twhunq/Fall-Detect/docs/reports/Slide_Thuyet_Trinh_Nhom_1.html

Tổng quan: nhấp vào slide để mở, phím O hoặc Esc để đóng

Logo ICTU

Trường Đại học Công nghệ Thông tin và Truyền thông, Đại học Thái NguyênKhoa Kỹ thuật và Công nghệ

Tiểu luận học phần Internet Vạn Vật

# Hệ thống IoT phát hiện và cảnh báo té ngã

Vòng đeo TinyML trên ESP32-S3 kết hợp camera AI CanMV K230

Nhóm thực hiệnNhóm 1, lớp VMBD K23A

Giảng viên hướng dẫnTS. Vũ Chiến Thắng

Thời gianTháng 10/2026

Chào thầy và các bạn. Nhóm 1 trình bày hệ thống IoT phát hiện và cảnh báo té ngã, gồm hai thiết bị: vòng đeo TinyML trên ESP32-S3 và camera AI CanMV K230, cùng ứng dụng di động «Báo Ngã IoT».

Đường vẽ dưới tiêu đề là độ lớn gia tốc |a| của một cú ngã: đi lại bình thường, rơi tự do (|a| tụt xuống), va đập (vọt lên), rồi nằm yên. Đây cũng là chuỗi mà thuật toán của nhóm theo dõi. Thời lượng khoảng 15 phút, sau đó demo.

Phím: → / Space bước tiếp; N ghi chú; Shift+N cửa sổ ghi chú có đồng hồ; M bật/tắt hoạt cảnh (mặc định bật); mở với ?static để hiện ngay trạng thái cuối.

## Nguy hiểm nhất là nằm bất động sau ngã mà không ai biết

30–60phút

Nằm chờ lâu hơn mức này: hạ thân nhiệt, tiêu cơ vân, suy thận cấp, tỷ lệ tử vong tăng gấp đôi.

Mục tiêu: báo ngay khi xác nhận ngã

Vùng nguy hiểm

Ngã

30 phút

60 phút

#### Báo tại chỗ, không cần mạng

Còi và LED bật ngay; một chạm để tắt nếu báo nhầm.

#### Hai nguồn độc lập

Vòng đeo trên người và camera trong phòng.

#### Nhiều kênh cùng chạy

Kênh tới trước báo trước, các kênh sau làm dự phòng.

Theo WHO, té ngã là nguyên nhân tử vong do chấn thương không chủ ý đứng thứ hai toàn cầu.

Theo WHO, té ngã là nguyên nhân tử vong do chấn thương không chủ ý đứng thứ hai toàn cầu. Điều quyết định hậu quả không chỉ là cú va đập mà là thời gian nằm bất động (long-lie): chậm phát hiện quá 30–60 phút có thể dẫn đến hạ thân nhiệt, mất nước, tiêu cơ vân, suy thận cấp và làm tăng gấp đôi tỷ lệ tử vong (mục 1.1 báo cáo).

Giải pháp đơn lẻ còn hở: chỉ ngưỡng gia tốc thì báo giả khi ngồi phịch xuống ghế; chỉ camera thì có điểm mù và vấn đề riêng tư; chỉ xử lý trên cloud thì mất Internet là mất bảo vệ.

Bấm → hiện ba mục tiêu thiết kế.

## Hai thiết bị tự phát hiện tại chỗ, nhiều đường cùng chạy tới điện thoại

Mỗi thiết bị tự chạy AI tại biên, không cần máy chủ để quyết định ngãLớp tại chỗ: còi và LED bật ngay, không phụ thuộc mạngTrong nhà: gói UDP 4210 và Web Portal đi thẳng qua Wi-Fi, không cần TLSCầu nối camera phát BLE NOTIFY thẳng tới điện thoại ở gầnQua Internet: Firebase đẩy SSE tới app, Telegram và Gmail tới người thân

Bấm → bốn lần, mỗi lần bật một nhóm đường truyền.
(1) Tại chỗ: còi + LED trên vòng đeo, chạy độc lập mạng.
(2) Mạng nhà: vòng đeo và cầu nối camera phát gói UDP cổng 4210; ứng dụng hỏi Web Portal /api/status mỗi 2 s.
(3) Camera K230 gửi sự kiện qua UART 921600 sang cầu nối ESP32-S3; cầu nối phát BLE NOTIFY cho điện thoại ở gần.
(4) Qua Internet: Firebase Realtime Database đẩy SSE tới ứng dụng; Telegram và Gmail tới người thân; ảnh bằng chứng lên Cloud Relay.

Từ slide sau, sơ đồ này thu nhỏ ở góc phải để đánh dấu phần đang trình bày.

## Toàn bộ vòng đeo nằm trên một PCB 2 lớp 60 × 50 mm

Mô hình 3D mạch in vòng đeo (KiCad 10)

±4 g ±500 °/s

MPU6050 lấy mẫu 50 Hz qua I2C

0 lỗi DRC/ERC

Thiết kế trên KiCad 10

~14–18 giờ

Giám sát liên tục, pin 1000 mAh (ước tính)

~0,42 mA

Ngủ sâu toàn mạch, hơn 60 ngày chờ

Ảnh: mô hình 3D mạch in từ KiCad 10 (Hình 2.3–2.4). Bấm → hiện chú thích linh kiện, bấm tiếp → số liệu điện năng (Bảng 2.3, ước tính).

GPIO đã đối chiếu PCB: SDA 8, SCL 9, MPU INT 7, TTP223 OUT 4 (HIGH khi chạm), còi chủ động 5 qua Q1 S8050, LED đỏ 6, ADC pin 1 (cầu 100k/100k, đo tại VSW trước diode 1N5817), GPIO48 là LED RGB trạng thái mạng.
TTP223: chạm 1 lần tắt còi; chạm 3 lần hiệu chuẩn; giữ 3 s ngủ sâu.
Điện năng: giám sát liên tục ~52–65 mA (~14–18 giờ với pin 1000 mAh); báo động ~95–130 mA trong 15–30 s; ngủ sâu ~0,42 mA toàn mạch (ESP32-S3 ~8 µA).
Câu hỏi hay gặp: vì sao đo pin trước diode (tránh sai số sụt áp, không rò dòng khi tắt công tắc).

## Ngã = va đập + bằng chứng + nằm yên ở tư thế mới

Mỗi 20 ms: đọc cảm biến, lọc, rồi chờ một cú va đập |a| ≥ 2,0 gVa đập: sự kiện nghi ngã (fall candidate), thiết lập kết nối trước (connection pre-warming)Tại t₀ + 3 s phải đủ cả hai điều kiện mới báo ngã, thiếu một là loại bỏ (rejected)Song song, MLP xét cửa sổ 1 s và góp một phiếu bằng chứngCa ngã thật: rơi tự do, va đập, nằm yên ở tư thế mới, báo độngVấp rồi tự đứng dậy: có bằng chứng nhưng không nằm yên, loại bỏ

Lưu đồ đúng theo mã nguồn: fall_detection_esp32.ino (updateSensor), fall_detector.h, detection_config.h, board_config.h.
Bấm → lần lượt: (1) nhánh chờ, (2) pha xác minh sự kiện nghi ngã (fall candidate), (3) hai quyết định, (4) nhánh MLP, (5) token chạy ca ngã thật, (6) ca bị loại.

• Đọc MPU6050 ±4 g, ±500 °/s; lọc nhiễu, trừ bias gyro (cập nhật chậm khi đứng yên), xoay về hệ trục chuẩn đã hiệu chỉnh khi đứng.
• CHỜ: tư thế tham chiếu là trung bình chậm của vector trọng lực khi ít chuyển động; ghi rơi tự do nếu |a| < 0,6 g.
• |a| ≥ 2,0 g → phát hiện nghi ngã tại t₀, bắt đầu pha xác minh: lưu tư thế trước, có rơi tự do trong 1 s trước va đập không, đỉnh tốc độ quay. Ngay lúc đó thiết lập kết nối trước (connection pre-warming): tắt Modem Sleep 10 s, CloudSync dựng sẵn phiên TLS (keep-alive).
• 0–1 s: pha ổn định (settling, bỏ qua nảy), vẫn cập nhật đỉnh |a|, đỉnh quay (đến 1,5 s) và phiếu ML.
• 1–3 s: pha xác minh tư thế, đếm tỉ lệ mẫu yên (| |a| − 1 | < 0,2 g và |ω| < 30 °/s), cộng dồn hướng trọng lực sau ngã.
• Tại 3 s: Bằng chứng = rơi tự do HOẶC phiếu ML HOẶC đỉnh quay ≥ 120 °/s; Nằm xuống = tỉ lệ yên ≥ 80 % VÀ góc lệch so với trước va đập ≥ 45°. Đủ cả hai → NGÃ; ngược lại loại bỏ (rejected): log «[FALL?] … -> bo qua» và về CHỜ. Không có nhánh «đứng dậy → hủy» riêng: đứng dậy làm tỉ lệ yên hoặc góc không đạt.
• NGÃ → AlertController.trigger (bị chặn 10 s sau lần chạm xác nhận trước; không kích hoạt chồng khi đang báo) → còi + LED, UDP ×3 (0/20/40 ms), đánh thức CloudSync (Fast-Flush Firebase) rồi Notifier (Telegram → Gmail). Chạm TTP223 tắt báo động tại chỗ.
• Song song: InactivityMonitor đếm thời gian bất động (mặc định 60 phút, chỉnh 1–1440) → cảnh báo vàng, tự báo «đã cử động trở lại».
Kết quả T02: còi bật sau 3,02 s (1 s ổn định + 2 s xác minh tư thế).

## Trên tín hiệu |a|, cú ngã hiện rõ ba mốc của lưu đồ

Đi lại bình thường: |a| dao động quanh 1 gRơi tự do: |a| tụt dưới 0,6 g, được ghi lại làm bằng chứngVa đập |a| ≥ 2,0 g tại t₀: phát hiện nghi ngã, thiết lập kết nối trướcPha ổn định 1 s; MLP xét cửa sổ quanh va đập và góp phiếu ngãPha xác minh tư thế 2 s: nằm yên, lệch tư thế đủ lớn, xác nhận ngã tại t₀ + 3 s

#### MLP 30 → 16 → 8 → 5 chạy ngay trên ESP32-S3

30 đặc trưng mỗi 200 ms: trung bình, độ lệch, max, min, RMS của 6 kênh.

677 tham số; kết quả C++ khớp NumPy, sai lệch < 0,0001.

Đường |a| là minh họa dựng theo mô tả Hình 3.6 của báo cáo, không phải bản ghi thô. Bấm → lần lượt từng mốc, khớp với lưu đồ slide trước.

MLP: cửa sổ 50 mẫu × 6 kênh (1 s), trượt 10 mẫu (200 ms); 30 đặc trưng = μ, σ, max, min, RMS × 6 kênh, chuẩn hóa Z-score; mạng 30 → 16 (ReLU) → 8 (ReLU) → 5 (Softmax), 677 tham số float32 (W1 480, b1 16, W2 128, b2 8, W3 40, b3 5) lưu trong Flash, không cấp phát động. 5 lớp: bình thường, ngã, ngồi, nằm, chạy.
Phiếu ML chỉ tính khi lớp «ngã» có độ tin cậy ≥ 0,70 và trong 1,5 s sau va đập.
So khớp C++17 với NumPy: sai lệch tuyệt đối lớn nhất < 0,0001 trên 602 cửa sổ. Train/Test 100 % trên tập dữ liệu chuẩn hóa quy mô vừa của nhóm (nói trung thực: cần tinh chỉnh trên SisFall). T02: lớp «ngã» đạt 94–99 %.

## Camera chỉ báo khi 6/10 khung đồng ý, giữ đủ 1,5 s

Mỗi khung: YOLOv5n tìm người, tracker giữ đúng danh tính qua các khungMột phiếu ngã chỉ khi người đang nằm và có thêm dấu hiệu ngãBỏ phiếu 6 trong 10 khung gần nhất để lọc nhiễu từng khungMáy trạng thái 3 trạng thái cho mỗi người: NORMAL, SUSPECT, ALARMCa ngã: đủ 6/10 phiếu, giữ 1,5 s, vào ALARM và gửi sự kiệnCúi nhặt đồ: phiếu tụt xuống trước 1,5 s, quay về NORMAL

Đúng theo falldown_detect.py (tham số lớp CFG; Track.update và Track._step_state).
• Ảnh 640 × 360, đưa vào YOLOv5n 640 × 640 (lớp Fall/NoFall), ngưỡng tin cậy 0,30, NMS 0,45. Ghép track khi IoU ≥ 0,30; mất dấu quá 2 s thì xóa track. (Giá trị theo mã nguồn hiện tại.)
• Tín hiệu mỗi khung: nằm = tỉ lệ w/h > 0,95; tụt nhanh = tâm khung tụt > 18 % chiều cao ảnh trong 8 khung. Phiếu = 1 khi NẰM và (model báo Fall HOẶC tụt nhanh); model báo Fall nhưng vẫn đứng → phiếu 0.
• «Đã ngã» khi ≥ 6 phiếu trong 10 khung gần nhất.
• NORMAL → SUSPECT khi đã ngã. SUSPECT → NORMAL nếu hết «đã ngã» (cúi, ngồi). Giữ SUSPECT ≥ 1,5 s → ALARM nếu đã qua 15 s từ lần báo trước, ngược lại về NORMAL. ALARM → NORMAL khi hết «đã ngã» liên tục ≥ 3 s (đứng dậy).
• Vào ALARM: gửi FALL qua UART 921600 sang cầu nối ESP32-S3 (BLE NOTIFY ngay, UDP, Relay/Telegram) và lưu ảnh bằng chứng. Tốc độ thực đo ~26 FPS (T11), bản tin UART < 5 ms.
Hoạt cảnh là minh họa chiếu chậm.

## Chỉ một phiên TLS mỗi lúc, cảnh báo khẩn được đi trước

### Mở chồng phiên TLSvấn đề

RAM trong (SRAM) còn trống

Firebase

Telegram

Gmail

Mỗi phiên cần ~40–46 KB: mở cùng lúc là cạn RAM, thiết bị khởi động lại.

### TlsGategiải pháp

1 phiên tại mọi thời điểm

Các tác vụ xếp hàng qua cổng.

Đệm TLS nằm ở PSRAM

SRAM còn dư cho Wi-Fi và Web Portal.

Firebase, Telegram và Gmail đều là TLS. Mỗi phiên cần khoảng 40–46 KB heap; mở chồng nhiều phiên là cạn SRAM và thiết bị khởi động lại.
Giải pháp: (1) cấp phát đệm mbedTLS sang PSRAM 2 MB (tlsCalloc), SRAM trống tăng thêm > 60 KB (số đo phiên bản trước); (2) khóa TlsGate tuần tự hóa: tối đa 1 phiên TLS tại mọi thời điểm.
Bấm → TlsGate; bấm tiếp → thứ tự khi có ngã: CloudSync đang giữ phiên TLS dựng sẵn làm Fast-Flush PUT trạng thái báo động lên Firebase, nhả cổng, rồi Notifier gửi Telegram, sau đó Gmail.
Các kênh khác: Web Portal baonga.local (cập nhật 1 s, SoftAP BaoNga-Setup khi chưa có Wi-Fi), Firebase RTDB + Hosting với quy tắc 3 vai trò device/owner/viewer. T08: Telegram=OK, Gmail=OK, heap trống > 120 KB.

## Năm lớp tăng tốc: kênh nào tới trước thì báo trước

1

#### UDP trong mạng nhàvòng đeo, cầu nối camera

3 gói cùng seq, cổng 4210, không TLS

< 15 mstrong mạng nội bộ

2

#### BLE không chặncầu nối camera

NOTIFY ngay khi nhận sự kiện ngã

~0 mslần gửi đầu tiên

3

#### Thiết lập kết nối trướcvòng đeo

Tắt Modem Sleep, dựng sẵn phiên TLS từ lúc va đập

0 lần bắt taykhi cần gửi

4

#### Fast-Flush Firebasevòng đeo

PUT báo động trên phiên TLS dựng sẵn (keep-alive)

~150 msgiới hạn chờ 1,5 s

5

#### Đua đa kênhứng dụng Báo Ngã IoT

Nghe mọi kênh, khử trùng lặp

kênh nhanh nhấtbật báo động

Cột phải là giá trị thiết kế (Bảng 3.15).

Trước đây mọi cảnh báo từ xa đi qua HTTPS/SMTPS, phải chờ bắt tay TLS, thường mất vài giây. Nay các đường chạy song song và độc lập về giao thức; đường chậm hơn là dự phòng khi đường nhanh đứt.
(1) UDP: 3 gói cùng seq cách 20 ms, broadcast + unicast tới tối đa 4 điện thoại vừa hỏi /api/status, cổng 4210, định dạng BAONGA|1|seq|device|FALL|metric|ip.
(2) BLE: NOTIFY đầu tại ~0 ms, các lần lặp do BleAlert::loop() đảm nhận; đường mạng phía sau bắt đầu sớm hơn 800 ms.
(3) Thiết lập kết nối trước: từ lúc va đập, tắt Modem Sleep 10 s, CloudSync dựng sẵn phiên TLS Firebase.
(4) Zero-Wait + Fast-Flush: đánh thức tác vụ bằng task notification, PUT trạng thái alarm ~150 ms (timeout 1,5 s) rồi nhường TlsGate.
(5) Ứng dụng nghe mọi kênh; kênh tới đầu tiên bật báo động, bản tin sau được khử trùng lặp.
Nhấn mạnh: các số ở cột phải là giá trị thiết kế (Bảng 3.15); độ trễ thật của từng sự cố xem ở mục «Thông tin kỹ thuật» trong chi tiết sự cố (tab Lịch sử) của ứng dụng.

## Mô phỏng: một cú ngã, sáu đường cùng chạy tới điện thoại

Vị trí về đích theo giá trị thiết kế, trục thời gian logaritCùng Wi-Fi nhà: UDP tới trước và bật báo động, các kênh sau chỉ ghi thêmNgười thân ở ngoài: chỉ còn đường Internet, Firebase tới trước

t = 0 msđồng hồ mô phỏng

Cùng Wi-Fi nhàỞ ngoài (4G)Phát lại

Mô phỏng theo giá trị thiết kế (Bảng 3.15), không phải số đo: UDP < 15 ms; BLE gửi tại ~0 ms (vị trí về đích minh họa); Firebase PUT ~150 ms rồi SSE; Portal hỏi mỗi 2 s; Telegram và Gmail vài giây (Gmail sau Telegram).
Bấm → kịch bản điện thoại cùng Wi-Fi: UDP tới trước, bật báo động; các kênh sau chỉ ghi thêm thời điểm tới, không đổ chuông lần hai. Bấm tiếp → người thân ở ngoài: UDP, BLE, Portal không khả dụng; Firebase SSE tới trước. Có thể bấm các nút trên khung để chạy lại.

## Tận dụng 3 giây xác minh để thiết lập kết nối trước, rồi đẩy Firebase đầu tiên

Vòng đeo, từ lúc va đập tới khi tin nhắn đi (giá trị thiết kế)t₀ va đập: thiết lập kết nối trước, tắt Modem Sleep 10 s, dựng sẵn phiên TLSt₀ + 3 s xác nhận: còi, LED và 3 gói UDP đi ngay, tác vụ mạng được đánh thứcFast-Flush trên phiên TLS dựng sẵn, nhả cổng, rồi Telegram và Gmail

Bấm → từng bước (Bảng 3.7, 3.8; giá trị thiết kế).
(1) Va đập ≥ 2 g, thiết lập kết nối trước: notifier.boost(10000) tắt Modem Sleep 10 s, cloud.prewarm() dựng sẵn phiên TLS Firebase.
(2) 3 s xác minh (1 s ổn định + 2 s xác minh tư thế): nếu sự kiện nghi ngã bị loại bỏ thì không phát gì, chi phí chỉ là Wi-Fi tốn điện thêm ≤ 10 s.
(3) Xác nhận: còi/LED; gói UDP 0/20/40 ms; đánh thức CloudSync và Notifier bằng task notification thay vì chờ chu kỳ.
(4) Fast-Flush: PUT alarm trên phiên TLS dựng sẵn (~150 ms, timeout 1,5 s), releaseTls(), Notifier gửi Telegram rồi Gmail. Luôn tối đa 1 phiên TLS.
Thêm (không có trên slide): cầu nối camera trước đây NOTIFY ×3 xen delay(400) chặn 800 ms rồi mới gọi HTTPS. Nay: NOTIFY và UDP tại 0 ms, HTTPS ngay sau; các lần lặp xử lý trong loop(). «Sớm hơn 800 ms» là hệ quả trực tiếp của việc bỏ 2 lần delay(400), không phải số đo. Hạn chế còn lại: lần lặp có thể bị hoãn khi loop() chờ HTTPS; hướng phát triển là đưa HTTPS sang task FreeRTOS riêng.

## Nhiều kênh, một sự cố: chỉ hú còi một lần, không bỏ sót cú ngã thứ hai

#### Tín hiệu tới ứng dụng (kịch bản minh họa)

#### Sự cố trên ứng dụng

AlertFusionEngine.ingest() (mobile/lib/core/fusion/alert_fusion_engine.dart). Nguồn: UDP 4210, BLE ALERT, Firebase SSE, Web Portal /api/status (2 s); trên app hiện là UDP, BLE, Cloud, LAN.
Quy tắc: (a) bản sao cùng nguồn, cùng loại trong 60 s bị khử; (b) gói UDP có seq khác = sự cố mới; (c) sự cố đã xác nhận chỉ gộp bản sao trễ trong 20 s kể từ lúc bắt đầu, nên cú ngã thứ hai sau khi xác nhận vẫn hú còi; (d) vòng đeo + camera cùng báo FALL trong 30 s → nhãn «Vòng đeo và camera cùng xác nhận», không đổ chuông lần hai; (e) RESUMED chỉ ghi thông tin và đóng sự cố bất động.
Kịch bản (thời gian minh họa): bấm → (1) UDP từ vòng đeo tới trước: sự cố mới, đổ chuông. (2) Firebase cùng sự cố: chỉ ghi thêm. (3) Camera báo qua BLE trong 30 s: gộp, nâng nhãn. (4) Người thân bấm «Đã kiểm tra, tắt chuông», sự cố thành «Đã xử lý»; bản Portal đến trễ trong 20 s vẫn bị gộp. (5) Cú ngã thứ hai, seq mới: sự cố mới, hú chuông lại. Có kiểm thử riêng cho tình huống (5).

## Ứng dụng Báo Ngã IoT gom mọi kênh về một màn hình cho người nhà

Tổng quan: Bà Lan đang an toàn

Báo động: Bà Lan có thể đã ngã

Lịch sử sự cố

Chi tiết sự cố

Tổng quan

### Bà Lan đang an toàn

Một câu trạng thái, khung camera, vòng đeo và camera, sự cố gần đây.

Khi có ngã

### Bà Lan có thể đã ngã

Nền đỏ toàn màn hình, chuông và rung cả khi app chạy nền; Gọi cấp cứu 115 hoặc Đã kiểm tra, tắt chuông.

Lịch sử

### Mỗi sự cố một dòng

Lọc Tất cả · Ngã · Không cử động; ghi rõ nguồn Vòng đeo và camera.

Chi tiết sự cố

### Nhiều kênh, một sự cố

Đến đầu tiên qua và mốc từng kênh nằm gọn trong mục Thông tin kỹ thuật.

Hợp nhất cảnh báoUDP, BLE, Cloud, LAN: một sự cố, một lần chuông

Chạy nềnAndroid Foreground Service, báo toàn màn hình

Không xin quyền SMSnút gọi chỉ mở trình quay số

Android APK · iOS IPAIPA cài qua Sideloadly

Ảnh chụp màn hình thật render từ mã nguồn ứng dụng (giao diện mới: tối giản kiểu iOS, xanh dương và trắng, font Be Vietnam Pro, 3 tab Tổng quan · Lịch sử · Cài đặt).
Bấm → lần lượt: (1) màn báo động đỏ toàn màn hình, «Vòng đeo và camera cùng xác nhận»; nút «Gọi cấp cứu 115» mở trình quay số, «Đã kiểm tra, tắt chuông» xác nhận sự cố. (2) Lịch sử, lọc Tất cả · Ngã · Không cử động. (3) Chi tiết sự cố: «Phát hiện bởi», «Độ chắc chắn», «Đến đầu tiên qua» (Wi-Fi nội bộ = UDP, Bluetooth = BLE, Cloud = Firebase SSE, LAN = hỏi trực tiếp vòng đeo qua Web Portal): dòng «Các kênh» cho mốc thời gian từng kênh. Thông số kỹ thuật chỉ nằm ở «Thông tin kỹ thuật» và Cài đặt › Chẩn đoán; hero Tổng quan đổi sang «Mất tín hiệu từ vòng đeo» khi quá 75 s không nhận được gì.
Ứng dụng Flutter cho Android (APK) và iOS (IPA chưa ký, cài qua Sideloadly); kiến trúc 5 lớp ui/state/services/platform/core; không dùng Firebase SDK (REST + SSE, Identity Toolkit) để chạy được trong isolate nền Android và bản iOS sideload. Android: Foreground Service, full-screen intent, FLAG_INSISTENT; không xin quyền SMS hay gọi điện. iOS: CoreBluetooth nền, chỉ nhận UDP unicast.
Ghép nối camera: QR chứa id và khóa thiết bị = HMAC-SHA256(MASTER_KEY, MAC); app ghi nonce, cầu nối trả 16 byte đầu HMAC(key, nonce); khớp mới cho ghi cấu hình và xem MJPEG.
Ứng dụng có kiểm thử tự động và đã chạy trên điện thoại thật.

## Thử trên phần cứng thật: ngã được báo sau 3,02 s, sinh hoạt không báo giả

3,02s

từ va đập tới còi + LED (T02)

0

báo giả khi sinh hoạt, gõ vỏ, chạy nhảy (T01, T03)

94–99%

độ tin cậy MLP lớp ngã (T02)

Phát hiệnTương tác, điện năngKết nối, cảnh báoCamera

T01

Sinh hoạt hằng ngày

0 lần báo giả

T02

Ngã chuẩn trên đệm

còi sau 3,02 sMLP ngã 94–99 %

T03

Gõ vỏ, chạy nhảy

tự loại bỏkhông báo giả

T04

Chạm tắt còi

< 50 msức chế 10 s

T05

Hiệu chuẩn, ngủ sâu

~8 µAhiệu chuẩn sau 1 s

T06

Bất động kéo dài

cảnh báo vàngbáo đã cử động trở lại

T07

Đồng bộ Firebase

5,5–9,5 stừ lúc khởi động, hai chiều

T08

Telegram + Gmail

cả hai OKheap trống > 120 KB

T09

Web baonga.local

< 100 msgửi thử thành công

T10

Mất Wi-Fi

còi vẫn kêugửi bù khi có mạng lại

T11

Camera K230

~26 FPSUART < 5 ms

T12

Ảnh bằng chứng

~32 KB JPEG640×360, vé SNAP

Kiểm thử tự động: 82 test Flutter · 7 chương trình C++17 · build 0 cảnh báo · APK 21,5–27,9 MB · IPA (app iOS) 7,9 MB

Kể T02 trước: ngã chuẩn lên đệm (va chạm ≥ 2,0 g + xoay người + nằm yên lệch > 45°) → còi BZ1 và LED D3 bật sau 3,02 s, khớp thiết kế 3,0 s (1 s ổn định + 2 s xác minh tư thế); độ tin cậy MLP lớp «ngã» 94–99 %. Rồi T01 và T03: sinh hoạt thường ngày (đi bộ, ngồi ghế, nằm xuống từ từ) 0 lần báo giả; gõ mạnh vỏ hoặc chạy nhảy (va chạm > 2 g nhưng không nằm yên) bị máy trạng thái tự loại bỏ (Verdict::Rejected), không báo giả.
Bấm → 12 thẻ, cả 12 kịch bản đều ĐẠT (Bảng 3.13): T04 chạm tắt còi < 50 ms, ức chế 10 000 ms; T05 chạm 3 lần hiệu chuẩn sau 1 s, giữ 3 s vào ngủ sâu, dòng MCU ~8 µA; T06 bất động: cảnh báo vàng, không bật còi lớn, gửi «ĐÃ CỬ ĐỘNG TRỞ LẠI» khi cầm lên; T07 Firebase đồng bộ xong sau 5,5–9,5 s từ lúc khởi động, cập nhật hai chiều; T08 Telegram=OK, Gmail=OK, heap trống > 120 KB; T09 Web baonga.local phản hồi < 100 ms, gửi thử thành công (pin 3,98 V, 76 %, RSSI −58 dBm); T10 mất Wi-Fi còi vẫn kêu, gửi bù cảnh báo khi kết nối lại; T11 camera K230 ~26 FPS, bản tin UART sang cầu nối < 5 ms; T12 ảnh JPEG 640×360 ~32 KB qua vé SNAP, hiển thị kèm cảnh báo Telegram/Web.
Dòng chân slide, kiểm thử tự động: flutter test 82 ca trong 10 tệp, flutter analyze 0 vấn đề; 7 chương trình C++17 trên máy tính (detection, inactivity, driver, runtime, notify, cloud, lan_alert; -Wall -Wextra -Werror) + test_flash.py; hai sketch ESP32-S3 và firmware cầu nối biên dịch 0 cảnh báo.
Bộ nhớ (Bảng 3.11, 3.10): vòng đeo Flash 1 287 983 / 1 966 080 B (65 %, min_spiffs) vì đã tích hợp Wi-Fi/TLS, Web, Firebase, UDP; RAM tĩnh 73 532 / 327 680 B (22 %). Cầu nối N16R8: Flash 1 479 081 / 6 553 600 B (22,6 %); RAM 68 116 B (20,8 %). APK tách theo kiến trúc: armeabi-v7a 21,5 MB, arm64-v8a 25,5 MB, x86_64 27,9 MB; bản gộp 68,5 MB. IPA chưa ký 7,9 MB, build trên macOS CI, cài qua Sideloadly.
Ứng dụng đã chạy trên điện thoại thật; các số độ trễ trên slide 9–10 là giá trị thiết kế.

## Hệ thống đã chạy thực tế; tiếp theo là tối ưu và đưa lên nhiều dạng thiết bị

### Đã làm được

- Phần cứng hoàn chỉnh trên PCB 2 lớp
- Ít báo giả: ba điều kiện cùng MLP
- Hai nguồn phát hiện, năm lớp cảnh báo

### Còn hạn chế

- MLP mới học trên tập dữ liệu quy mô vừa
- Ra Internet còn phụ thuộc Wi-Fi gia đình

### Hướng tiếp theo

- Tối ưu mô hình, pin và kích thước thiết bị
- Trang bị trên kính AI, đồng hồ, quần áo thông minh
- Thêm MAX30102, 4G/NB-IoT và GPS

Một lõi phát hiện, nhiều dạng thiết bịMở rộng từ vòng đeo hiện tại

Vòng đeo hiện tại

Kính AI

Đồng hồ thông minh

Quần áo thông minh

…

Tự đánh giá trung thực. Hệ thống đã chạy thực tế: vòng đeo, camera và ứng dụng trên điện thoại thật; độ trễ và dữ liệu đã được đo trên hệ thống thật. Ưu điểm: PCB 2 lớp 60 × 50 mm có ngủ sâu và đo pin; xác nhận ngã bằng va đập + bằng chứng + nằm yên, cộng TinyML và giám sát bất động nên ít báo giả; PSRAM tlsCalloc + TlsGate giải bài toán bộ nhớ TLS; đa phương thức vòng đeo + camera; đường cảnh báo 5 lớp và ứng dụng Android/iOS có 82 kiểm thử Flutter.
Hạn chế: MLP huấn luyện trên tập dữ liệu quy mô vừa, thử nghiệm có đệm bảo hộ; phụ thuộc vùng phủ Wi-Fi gia đình để ra Internet; iOS sideload bị tạm dừng nền khi không có kết nối BLE.
Hướng phát triển: (1) tối ưu mô hình, năng lượng/pin và thu nhỏ kích thước thiết bị; (2) trang bị lõi phát hiện trên nhiều dạng thiết bị: kính AI, đồng hồ thông minh, quần áo thông minh…; (3) MAX30102 đo nhịp tim, SpO2 sau ngã; NB-IoT/4G Cat-1 + GPS; vỏ in 3D IP65; đưa HTTPS của cầu nối camera sang task FreeRTOS riêng; multicast lock trên Android, APNs cho iOS.
Bấm → Còn hạn chế; bấm → Hướng tiếp theo; bấm → hàng thiết bị, vòng đeo hiện tại là gốc.

# Cảm ơn thầy và các bạn đã lắng nghe

Hỏi đáp và demo trực tiếp

#### Trong repo có

Firmware vòng đeo TinyMLCamera K230 + cầu nối ESP32App Flutter (APK/IPA)Firebase cloud + webPCB KiCad (Gerber, BOM, 3D)

#### Cùng phát triển

- Đưa lõi phát hiện lên kính AI, đồng hồ, quần áo thông minh
- Góp dữ liệu và kịch bản thử
- Mở issue, gửi pull request

Mã nguồn mở

github.com/twhunq/Fall-Detect

MIT · © 2026 Marine (Tuấn Hưng)

Nhóm 1, lớp VMBD K23A. Hệ thống IoT phát hiện và cảnh báo té ngã

Mã nguồn mở: toàn bộ dự án ở github.com/twhunq/Fall-Detect (quét QR), giấy phép MIT, © 2026 Marine (Tuấn Hưng). Trong repo: firmware vòng đeo TinyML, camera K230 + cầu nối ESP32-S3, app Flutter (APK/IPA), Firebase cloud + web, PCB KiCad (Gerber, BOM, mô hình 3D).
Cách đóng góp: fork repo, tạo nhánh, gửi pull request; báo lỗi hoặc đề xuất qua issue. Hướng mời cùng làm (khớp slide 15): đưa lõi phát hiện lên kính AI, đồng hồ, quần áo thông minh; góp dữ liệu và kịch bản thử.

Câu hỏi dự kiến: vì sao kết hợp điều kiện vật lý với MLP; đeo nghiêng có sai không (tư thế tham chiếu và góc lệch tính tương đối so với trước va đập); vì sao TLS dễ làm crash và cách xử lý (PSRAM + TlsGate); vì sao đo pin trước diode; vì sao gửi ảnh bằng vé SNAP thay vì qua UART. Câu hỏi về độ trễ: các con số trên slide 9–10 là giá trị thiết kế; độ trễ thật của từng sự cố xem trực tiếp ở mục «Thông tin kỹ thuật» trong chi tiết sự cố của app.

Kịch bản demo (~3,5 phút): khởi động và kiểm tra kết nối; hiệu chỉnh (chạm 3 lần); chống báo giả (đi, ngồi, cúi, vỗ máy); ngã lên đệm và nằm yên 3 s → còi/LED, web đỏ, Telegram + Gmail, app đổ chuông, camera cùng báo trong 30 s → «Vòng đeo và camera cùng xác nhận»; bất động 1 phút → cảnh báo vàng, cầm lên → «đã cử động trở lại». Nếu mạng lớp chập chờn: phần còi/LED vẫn chạy, mở slide mô phỏng đua đa kênh thay cho phần ứng dụng.

01 / 16

#### Mở cửa sổ riêng Đóng (N)

Phím tắt
→ Space PgDn bước tiếp, ← PgUp lùi
Home End slide đầu, cuối
F toàn màn hình, O tổng quan
N ghi chú, Shift+N cửa sổ ghi chú có đồng hồ
M bật/tắt hoạt cảnh (mặc định bật), ? bảng này
URL: #5.2 slide 5 bước 2, ?static hoặc ?instant tắt hoạt cảnh (chụp ảnh)
