twhunq/Fall-Detect/hardware/pcb/production/bom.csv

Ref | Value | Footprint | Qty
BZ1 | Buzzer 3V (active) | Buzzer_Beeper:Buzzer_12x9.5RM7.6 | 1
C1 | 100uF 16V | Capacitor_THT:CP_Radial_D6.3mm_P2.50mm | 1
C2-C4 | 100nF | Capacitor_THT:C_Disc_D5.0mm_W2.5mm_P5.00mm | 3
D1 | 1N4148 | Diode_THT:D_DO-35_SOD27_P7.62mm_Horizontal | 1
D2 | 1N5817 | Diode_THT:D_DO-41_SOD81_P10.16mm_Horizontal | 1
D3 | LED 5mm Red | LED_THT:LED_D5.0mm | 1
J1 | BAT (TP4056 OUT) | Connector_JST:JST_PH_B2B-PH-K_1x02_P2.00mm_Vertical | 1
Q1 | S8050 | Package_TO_SOT_THT:TO-92_Inline_Wide | 1
R1 | 1k | Resistor_THT:R_Axial_DIN0207_L6.3mm_D2.5mm_P7.62mm_Horizontal | 1
R2 | 10k | Resistor_THT:R_Axial_DIN0207_L6.3mm_D2.5mm_P7.62mm_Horizontal | 1
R3 | 330 | Resistor_THT:R_Axial_DIN0207_L6.3mm_D2.5mm_P7.62mm_Horizontal | 1
R4,R5 | 100k | Resistor_THT:R_Axial_DIN0207_L6.3mm_D2.5mm_P7.62mm_Horizontal | 2
SW1 | SS12D00 PWR | fall_detector:SW_Slide_SS12D00 | 1
U1 | ESP32-S3 SuperMini | fall_detector:ESP32-S3_SuperMini_Socket | 1
U2 | GY-521 MPU6050 | fall_detector:GY-521_MPU6050_Module | 1
U3 | TTP223 Touch | fall_detector:TTP223_Module | 1
