twhunq/Fall-Detect/hardware/pcb/enclosure/fall_detector_pcb.step

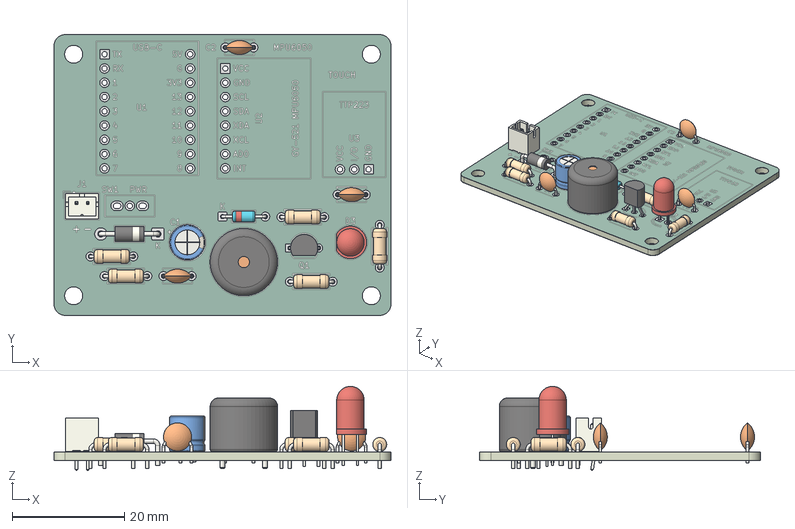
[picture p22: CAD file, 2026-10-11]
hardware/pcb/enclosure/fall_detector_pcb.step
60.0 x 50.0 x 15.0 mm
C_Disc_D50mm_W25mm_P500mm x 3
R_Axial_DIN0207_L63mm_D25mm_P762mm_Horizontal x 5
CP_Radial_D63mm_P250mm
D_DO-35_SOD27_P7.62mm_Horizontal
TO-92_Inline_Wide
LED_D5.0mm
D_DO-41_SOD81_P10.16mm_Horizontal
JST_B2B_PH_K
Buzzer_12x95RM76
fall_detector_pad
fall_detector_silkscreen x 2
fall_detector_soldermask x 2
fall_detector_PCB
