twhunq/Fall-Detect/hardware/pcb/docs/fall_detector_schematic.pdf

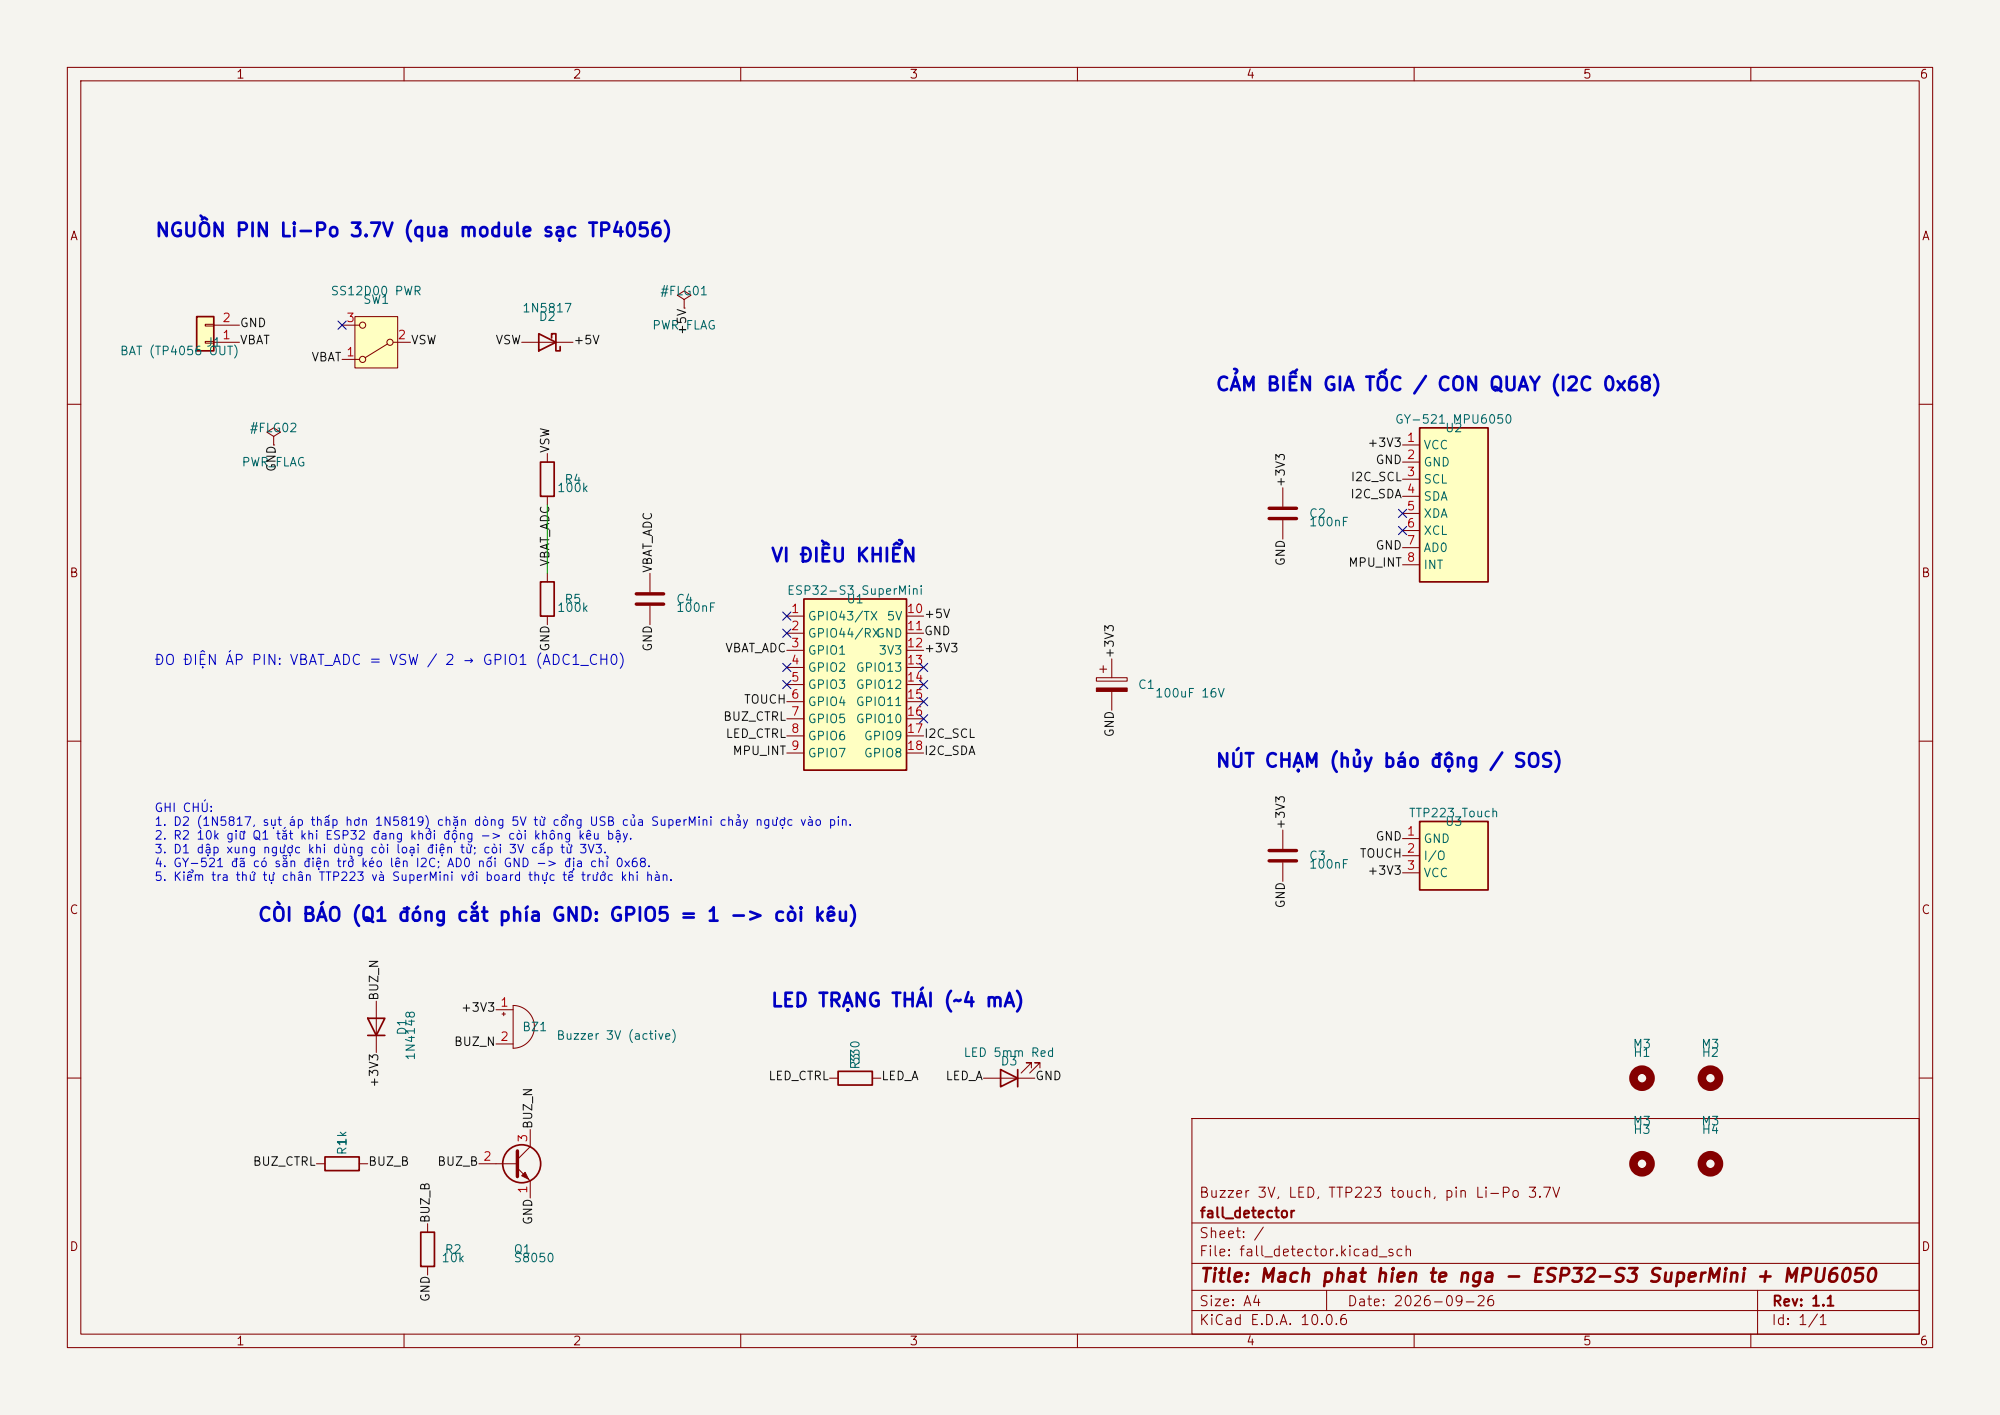
[picture p23: page 1]

CẢM BIẾN GIA TỐC / CON QUAY (I2C 0x68)

ĐO ĐIỆN ÁP PIN: VBAT_ADC = VSW / 2 → GPIO1 (ADC1_CH0)

TOUCH +3V3 GND GND GND

NÚT CHẠM (hủy báo động / SOS)

CÒI BÁO (Q1 đóng cắt phía GND: GPIO5 = 1 -> còi kêu)
BUZ_B +3V3 BUZ_N

LED TRẠNG THÁI (~4 mA)

Buzzer 3V, LED, TTP223 touch, pin Li-Po 3.7V D1 1N4148

fall_detector
Sheet: /
File: fall_detector.kicad_sch
Title: Mach phat hien te nga - ESP32-S3 SuperMini + MPU6050

Size: A4 | Rev: 1.1
KiCad E.D.A. 10.0.6 | Id: 1/1
