twhunq/Fall-Detect/hardware/pcb/fall_detector.kicad_pcb

## KiCad design hardware/pcb/fall_detector.kicad_pcb (2026-10-11)

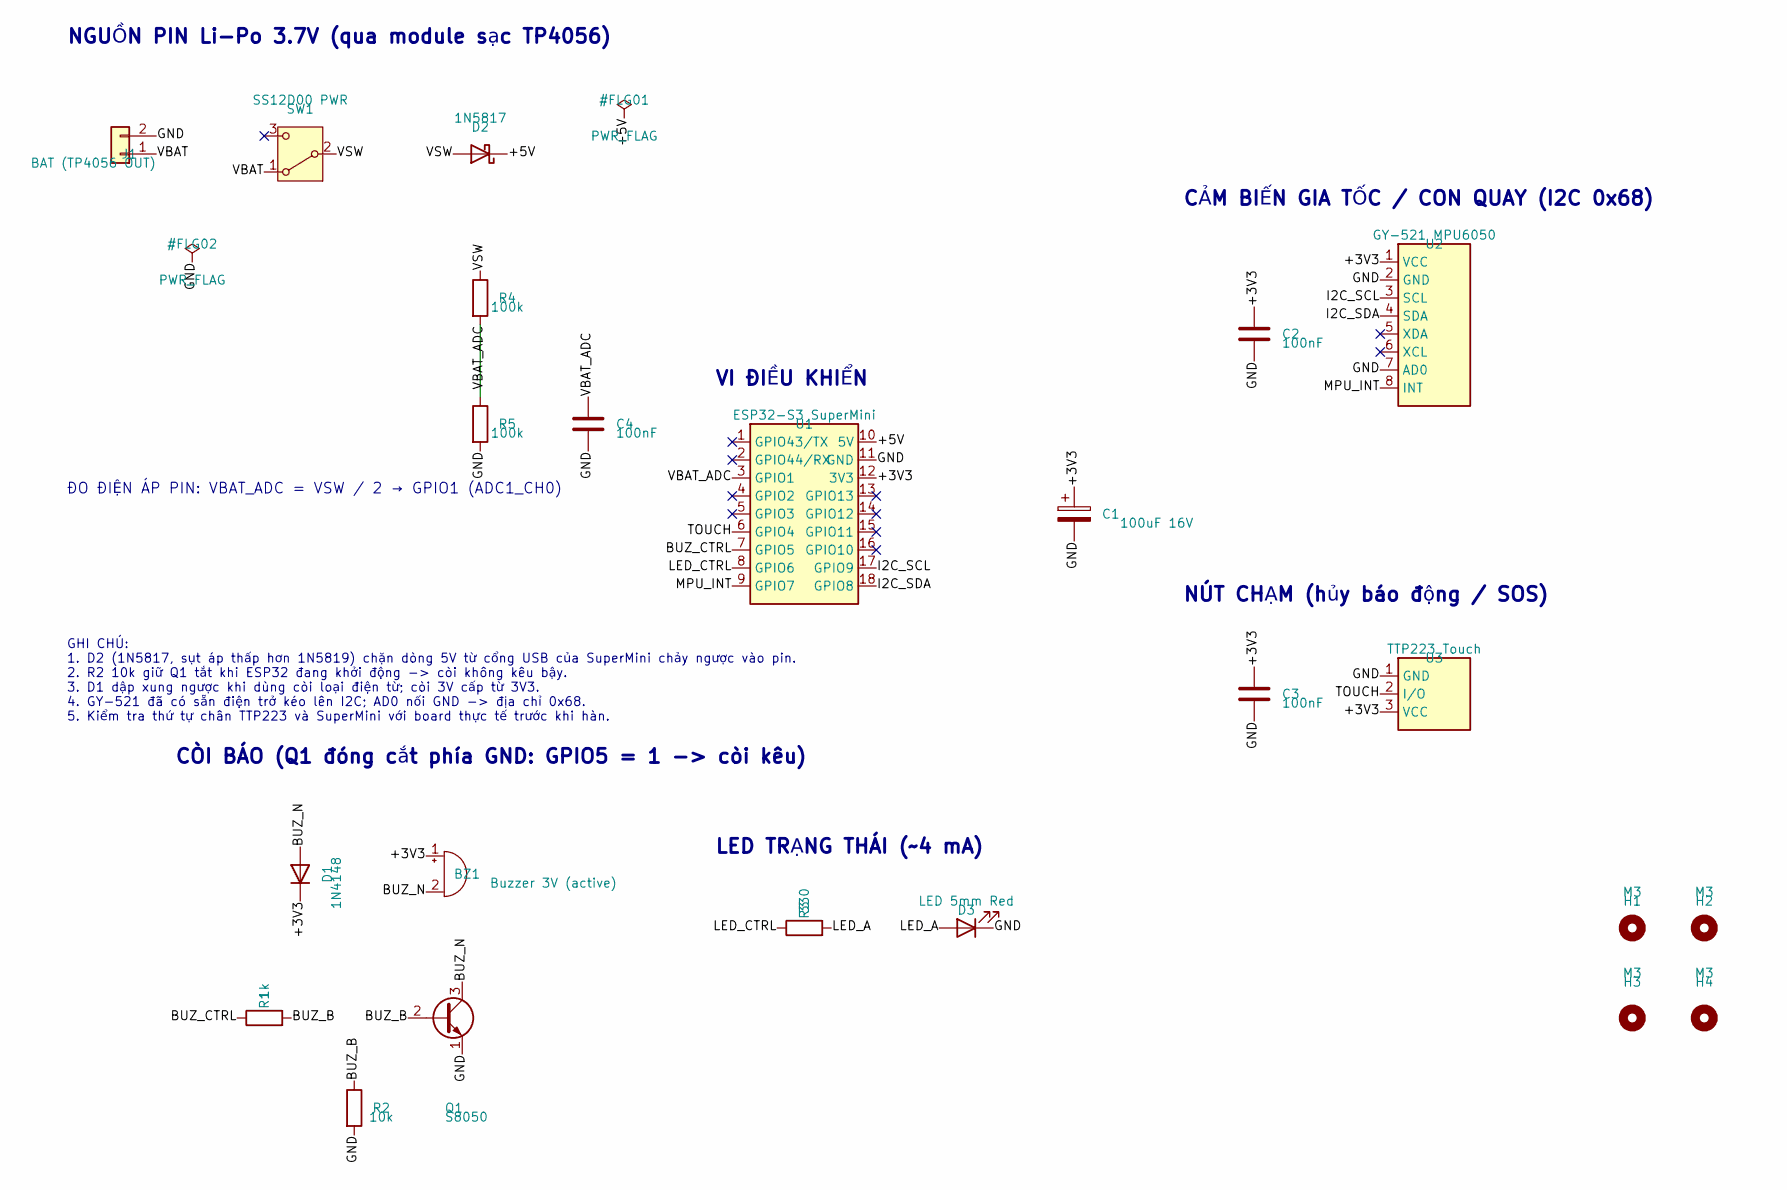
[picture p24: schematic fall_detector.kicad_sch, Mach phat hien te nga - ESP32-S3 SuperMini + MPU6050]

Parts:
BZ1: Buzzer 3V (active); Buzzer_12x9.5RM7.6
C1: 100uF 16V; CP_Radial_D6.3mm_P2.50mm
C2, C3, C4: 100nF; C_Disc_D5.0mm_W2.5mm_P5.00mm
D1: 1N4148; D_DO-35_SOD27_P7.62mm_Horizontal
D2: 1N5817; D_DO-41_SOD81_P10.16mm_Horizontal
D3: LED 5mm Red; LED_D5.0mm
H1, H2, H3, H4: M3; MountingHole_3.2mm_M3
J1: BAT (TP4056 OUT); JST_PH_B2B-PH-K_1x02_P2.00mm_Vertical
Q1: S8050; TO-92_Inline_Wide
R1: 1k; R_Axial_DIN0207_L6.3mm_D2.5mm_P7.62mm_Horizontal
R2: 10k; R_Axial_DIN0207_L6.3mm_D2.5mm_P7.62mm_Horizontal
R3: 330; R_Axial_DIN0207_L6.3mm_D2.5mm_P7.62mm_Horizontal
R4, R5: 100k; R_Axial_DIN0207_L6.3mm_D2.5mm_P7.62mm_Horizontal
SW1: SS12D00 PWR; SW_Slide_SS12D00
U1: ESP32-S3 SuperMini; ESP32-S3_SuperMini_Socket
U2: GY-521 MPU6050; GY-521_MPU6050_Module
U3: TTP223 Touch; TTP223_Module

Connections:
/+3V3: BZ1.1 (+), C1.1, C2.1, C3.1, D1.1 (K), U1.12 (3V3), U2.1 (VCC), U3.3 (VCC)
/+5V: D2.1 (K), U1.10 (5V)
/BUZ_B: Q1.2 (B), R1.2, R2.1
/BUZ_CTRL: R1.1, U1.7 (GPIO5)
/BUZ_N: BZ1.2 (-), D1.2 (A), Q1.3 (C)
/GND: C1.2, C2.2, C3.2, C4.2, D3.1 (K), J1.2, Q1.1 (E), R2.2, R5.2, U1.11 (GND), U2.2 (GND), U2.7 (AD0), U3.1 (GND)
/I2C_SCL: U1.17 (GPIO9), U2.3 (SCL)
/I2C_SDA: U1.18 (GPIO8), U2.4 (SDA)
/LED_A: D3.2 (A), R3.2
/LED_CTRL: R3.1, U1.8 (GPIO6)
/MPU_INT: U1.9 (GPIO7), U2.8 (INT)
/TOUCH: U1.6 (GPIO4), U3.2 (I/O)
/VBAT: J1.1, SW1.1 (A)
/VBAT_ADC: C4.1, R4.2, R5.1, U1.3 (GPIO1)
/VSW: D2.2 (A), R4.1, SW1.2 (B)

Notes on the sheet:
NGUỒN PIN Li-Po 3.7V (qua module sạc TP4056)
ĐO ĐIỆN ÁP PIN: VBAT_ADC = VSW / 2 → GPIO1 (ADC1_CH0)
VI ĐIỀU KHIỂN
CẢM BIẾN GIA TỐC / CON QUAY (I2C 0x68)
NÚT CHẠM (hủy báo động / SOS)
CÒI BÁO (Q1 đóng cắt phía GND: GPIO5 = 1 -> còi kêu)
LED TRẠNG THÁI (~4 mA)
GHI CHÚ: 1. D2 (1N5817, sụt áp thấp hơn 1N5819) chặn dòng 5V từ cổng USB của SuperMini chảy ngược vào pin. 2. R2 10k giữ Q1 tắt khi ESP32 đang khởi động -> còi không kêu bậy. 3. D1 dập xung ngược khi dùng còi loại điện từ; còi 3V cấp từ 3V3. 4. GY-521 đã có sẵn điện trở kéo lên I2C; AD0 nối GND -> 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

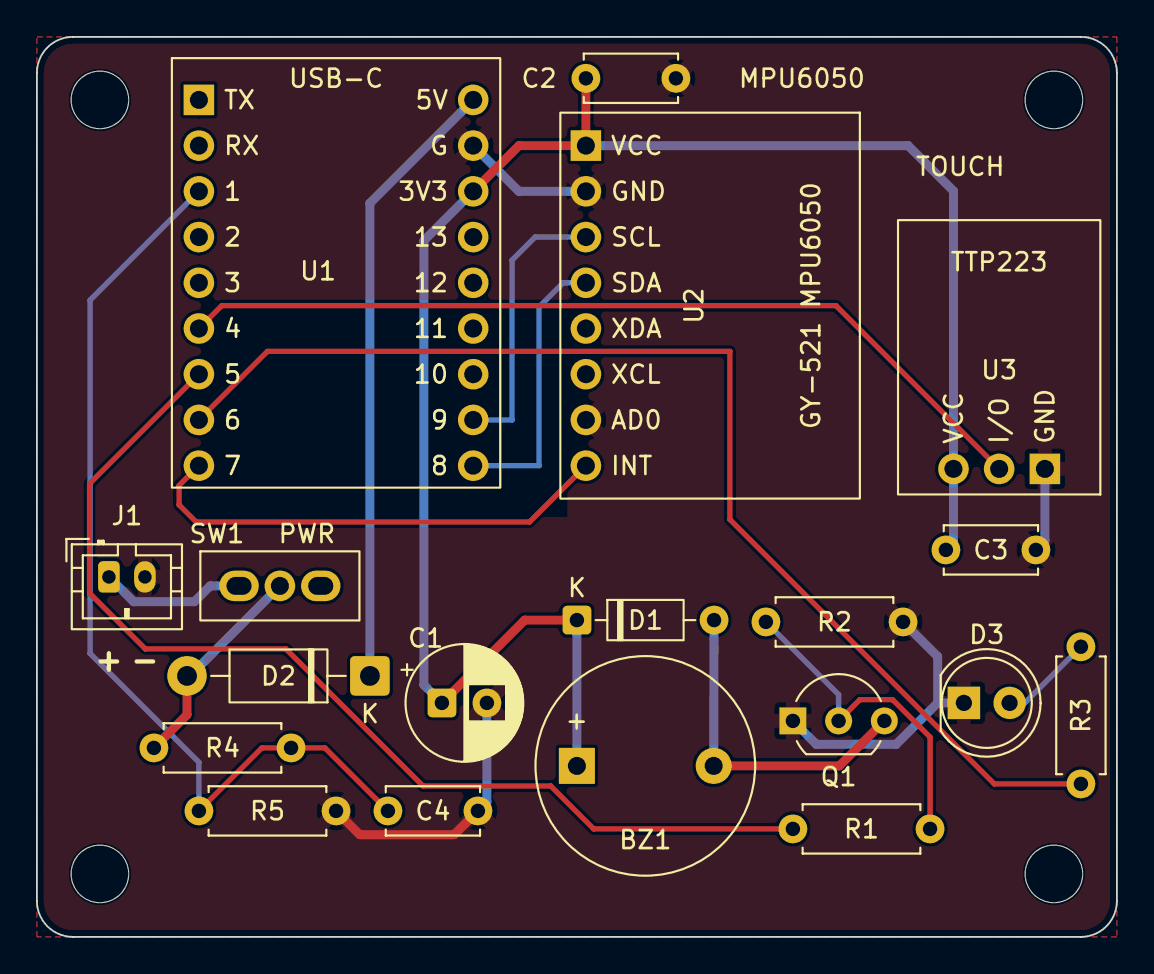
[picture p25: board fall_detector.kicad_pcb from above]

Board: 2 copper layers, 60.0 x 50.0 mm, 23 parts (0 on the bottom side), 15 nets.
