twhunq/Fall-Detect/firmware/wearable/src/fall_detection_esp32/model_weights.h

// =========================================================================
// model_weights.h - TU DONG SINH BOI train_model.py - KHONG CHINH SUA TAY
//
// Mo hinh MLP 30 -> 16 -> 8 -> 5 (ReLU, ReLU, Softmax)
// Do chinh xac tren tap train : 100.00%
// Do chinh xac tren tap test  : 100.00%
// Tong so tham so             : 677
// =========================================================================
#ifndef MODEL_WEIGHTS_H
#define MODEL_WEIGHTS_H

#define INPUT_SIZE  30
#define HIDDEN1_SIZE 16
#define HIDDEN2_SIZE 8
#define OUTPUT_SIZE 5

// Ten 5 lop, THEO DUNG THU TU voi cac neuron dau ra (bang alphabet,
// giong hanh vi cua sklearn LabelEncoder da dung khi huan luyen).
static const char* CLASS_NAMES[OUTPUT_SIZE] = {"di_bo", "dung", "nam", "nga", "ngoi"};

// Tham so chuan hoa (StandardScaler) - ap dung cho vector 30 dac trung
// TRUOC khi dua vao mo hinh: x_norm[i] = (x[i] - FEATURE_MEAN[i]) / FEATURE_STD[i]
static const float FEATURE_MEAN[INPUT_SIZE] = {0.22658438f, 0.04736592f, 0.08836517f, 0.36564302f, 0.25802060f, 0.01897407f, 0.03386228f, -0.05715150f, 0.09575173f, 0.04543183f, 0.64983214f, 0.12323398f, 0.52183651f, 1.19923845f, 0.71078320f, 1.57103908f, 8.88068674f, -10.47297381f, 22.27557331f, 9.22754848f, 0.08723180f, 8.20326126f, -19.70198004f, 20.38662827f, 8.25493752f, 0.08642178f, 5.65420178f, -15.51045384f, 15.72558744f, 5.71163934f};
static const float FEATURE_STD[INPUT_SIZE]  = {0.36582083f, 0.03620626f, 0.44601538f, 0.36777231f, 0.34949271f, 0.02546844f, 0.01096123f, 0.04219051f, 0.03199126f, 0.01453989f, 0.42680476f, 0.15303862f, 0.44990486f, 0.74976887f, 0.37126646f, 3.22916842f, 8.94128525f, 12.11119193f, 24.88909414f, 9.30382827f, 1.28504091f, 8.12743101f, 22.57511119f, 23.50469515f, 8.17701511f, 1.27993230f, 6.64849558f, 21.42411164f, 21.77161701f, 6.72274964f};

// ---- Lop An 1 (Input 30 -> Hidden1 16), kich hoat ReLU ----
static const float W1[INPUT_SIZE][HIDDEN1_SIZE] = {
  {0.03624517f, 0.23276584f, 0.09624952f, 0.12705546f, -0.42782960f, -0.33345161f, -0.16806746f, 0.19259963f, -0.00791430f, 0.02384154f, -0.40763312f, 0.38983642f, 0.43596278f, -0.13342603f, -0.34172232f, -0.33673105f},
  {-0.33800283f, -0.18662968f, -0.15342084f, -0.35291573f, 0.00322427f, -0.48432488f, -0.26720147f, 0.02595574f, -0.02676857f, 0.12200381f, -0.11997149f, -0.09986139f, 0.13894510f, -0.30836109f, 0.00477378f, -0.10229148f},
  {-0.04676064f, 0.24148924f, 0.28480106f, 0.29037504f, -0.21328811f, -0.32737777f, 0.31109526f, -0.13528592f, -0.32529852f, -0.12586396f, -0.42902963f, 0.35919201f, 0.01769102f, 0.18981833f, -0.20926738f, -0.11573858f},
  {0.05029237f, -0.33179085f, 0.21113070f, 0.23929909f, 0.12529160f, 0.19815381f, 0.17832296f, 0.29788430f, -0.38780394f, -0.34299107f, -0.32536335f, -0.08986666f, 0.09755098f, -0.08890188f, 0.09902970f, 0.03688766f},
  {-0.08046388f, -0.06403226f, -0.33788188f, 0.27443808f, -0.50503664f, 0.24736667f, 0.32688626f, -0.27821581f, -0.45356513f, 0.10227569f, 0.10492914f, 0.20820638f, 0.38401150f, -0.23255885f, -0.22260672f, -0.32861820f},
  {0.41610716f, -0.04834266f, -0.28025415f, -0.41996600f, -0.33293155f, -0.04867437f, 0.35878798f, -0.00019335f, 0.50058362f, 0.07005691f, -0.31500982f, 0.33462361f, 0.14823328f, 0.09705151f, 0.21341599f, -0.06696036f},
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
  {0.40090776f, -0.56992433f, -0.75490672f, -0.39530100f, -0.53538487f},
  {-0.43221673f, -0.57744442f, -0.34590234f, -0.53453589f, 0.72286952f}
};
static const float BIAS3[OUTPUT_SIZE] = {-0.56118213f, -0.25349056f, 0.22677218f, 0.48575210f, -0.71702008f};

#endif // MODEL_WEIGHTS_H
