twhunq/Fall-Detect/(commit log)

2026-10-31 feat: reorganize monorepo, 5-layer low-latency alert pipeline & Flutter mobile app (APK + iOS Sideloadly IPA)
    [bom.csv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]
2026-10-31 fix(wearable): resolve chunked keep-alive sync stall, GFE 60s rollover, cold-boot IMU retry & Windows USB-JTAG flash
    [cloud_sync.h, fall_detection_esp32.ino, flash.py, test_flash.py, web_portal.h]
2026-10-31 feat(mobile): redesign UI toi gian kieu iOS + phat hien mat tin hieu, pin %, ten nguoi theo doi
    - 3 tab Tong quan / Lich su / Cai dat; thong so ky thuat gom vao trang Chan doan
    - Hero trang thai: an toan / nga / khong cu dong / mat tin hieu (>75 s) / dang ket noi
    - Pin hien thi % (bang LiPo 1 cell), "Cam nguon" khi < 2000 mV
    - Ten nguoi duoc theo doi luu tai /devices/<id>/profile/name (rules: owner ghi), web dashboard hien ten
    - Man bao dong: goi 115 + xac nhan; bo lien he SOS rieng
    - Font Be Vietnam Pro, token mau xanh duong/trang (mobile/DESIGN.md), phien ban 1.1.0+2
2026-10-31 docs: chuan hoa thuat ngu (AIoT -> IoT, nghi nga, thiet lap ket noi truoc, pha on dinh/xac minh tu the)
    - README, firmware/wearable/README, bao cao .docx, slide .pptx/.html
    - Tin nhan Telegram cua cau noi camera K230 doi "AIoT" thanh "IoT"
2026-10-31 fix(camera-bridge): chong sut ap khi khoi dong, kiem tra day UART toi K230
    - BLE TX mac dinh +3 dBm (P18 gay BROWNOUT_RST khi chung nguon voi K230)
    - Gioi han cong suat Wi-Fi 8.5 dBm qua esp_wifi (country VN, policy MANUAL)
    - Kiem tra dien ap 2 chan UART truoc khi mo cong; giu TX o High-Z khi K230 tat nguon
    - Log HB K230 (fps, so nguoi), canh bao neu 30 s chua co tin hieu
    - NVS mo che do doc-ghi de khong in loi NOT_FOUND lan dau; SNTP phan giai DNS truoc
    - CPU 160 MHz
    [ble_alert.h, device_config.h, device_identity.h, main.cpp, telegram_alert.h]
2026-10-31 slide: nut toan man hinh, nen lien mach, tat goi y dich, tep mo toan man hinh
